DoHyun0226/Line_Tracer/자료/README.md

# 자료

라인트레이서를 만들면서 참고하는 자료를 모아 둔 폴더이다.

## 데이터시트

| 파일 | 내용 |
|---|---|
| [KH42J.pdf](KH42J.pdf) | KH42 스텝모터. KH42JM2-901은 1.8°/스텝, 유니폴라 6선, 1.2A/상 |
| [drv8825.pdf](drv8825.pdf) | DRV8825 스테퍼 드라이버 |
| [tcrt5000.pdf](tcrt5000.pdf) | TCRT5000 적외선 광센서 |

## 구매 자료

| 파일 | 내용 |
|---|---|
| [라인트레이서 추가 구매 체크리스트.pdf](<라인트레이서 추가 구매 체크리스트.pdf>) | 2026-10-13에 작성한 부품 체크리스트 |

## 학습용 HTML

GitHub에서는 소스 코드로만 보이므로, 내려받아 브라우저로 연다.

| 파일 | 내용 |
|---|---|
| [28BYJ-48_Anatomy.html](28BYJ-48_Anatomy.html) | 28BYJ-48 내부 구조와 ULN2003 구동 3D 모델 |
| [Stepper_Wiring.html](Stepper_Wiring.html) | 6선 유니폴라, 5선 유니폴라, 4선 바이폴라 결선과 전류 흐름 비교 |
| [KH42 스테퍼 해부.html](<시뮬레이션/KH42 스테퍼 해부.html>) | KH42JM2-901 구조와 구동 방식 3D 모델 |
| [GPIO_Pull_Guide.html](시뮬레이션/GPIO_Pull_Guide.html) | GPIO 풀업·풀다운 정리와 시뮬레이터 |

## 참고 코드

| 폴더 | 내용 |
|---|---|
| [Arduino_Stepper](Arduino_Stepper) | Arduino Stepper 라이브러리 1.1.3. 스텝모터 구동 방식 참고용이며 라이선스는 폴더 안의 `LICENSE.txt` 참고 |
