DoHyun0226/Line_Tracer/자료/Stepper_Wiring.html

2상 스텝모터 결선 비교

# 핀에서 코일까지 전류 따라가기

6선 유니폴라, 5선 유니폴라, 4선 바이폴라에서 핀이 코일 어디에 연결되고, 스텝마다 전류가 어떻게 흐르는지 비교해 보세요.

6선 유니폴라 5선 유니폴라 4선 바이폴라

2상 여자 1상 여자

◀ 한 스텝 한 스텝 ▶ 자동 진행

## 핀 연결과 현재 상태

## 스텝 순서

## 비교할 점

- 6선과 5선은 스텝마다 켜는 코일이 같아요. 가운데 탭이 코일마다 따로 나오느냐, 모터 안에서 하나로 묶였느냐가 달라요.
- 5선과 4선은 2상 여자에서 자기장 방향이 같아요. 5선은 코일 절반을 골라 켜고, 4선은 코일 전체의 전류 방향을 뒤집어요.
- 5선 모드의 2상 여자 표는 STM32 코드의 step_table 값 0x3, 0x6, 0xC, 0x9와 같은 순서예요.
- 주황·분홍이 한 코일, 노랑·파랑이 한 코일이에요. IN 번호와 선 색의 대응은 보드마다 다를 수 있어요.
- 6선과 4선의 선 이름은 설명용이에요. 실제 선 색은 제품마다 달라서 데이터시트나 멀티미터로 확인해야 해요.
- 그림은 전기적 연결을 보여 주는 회로도예요. 코일의 좌우와 화살표 방향은 실제 극 배치와 일치하지 않아요.
