DoHyun0226/Line_Tracer/실험_사진/28_BYJ_48_Test/2_nucleo_wiring.jpg

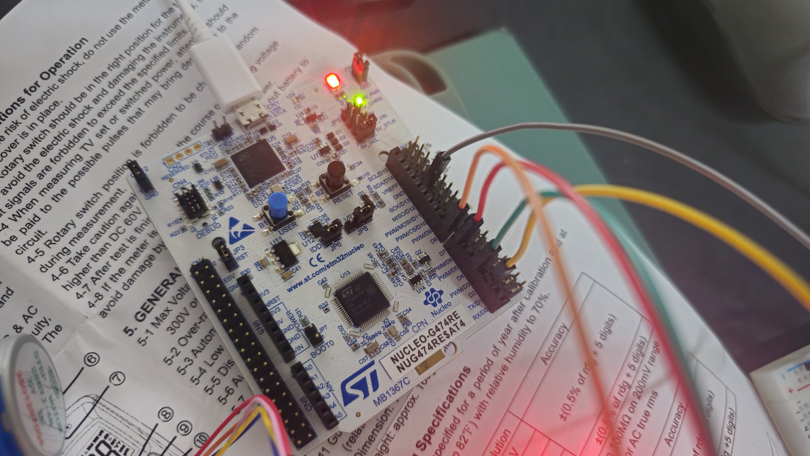
실험_사진/28_BYJ_48_Test/2_nucleo_wiring.jpg
