DoHyun0226/Line_Tracer/실험_사진/TCRT5000_Test/4_nucleo_wiring.jpg

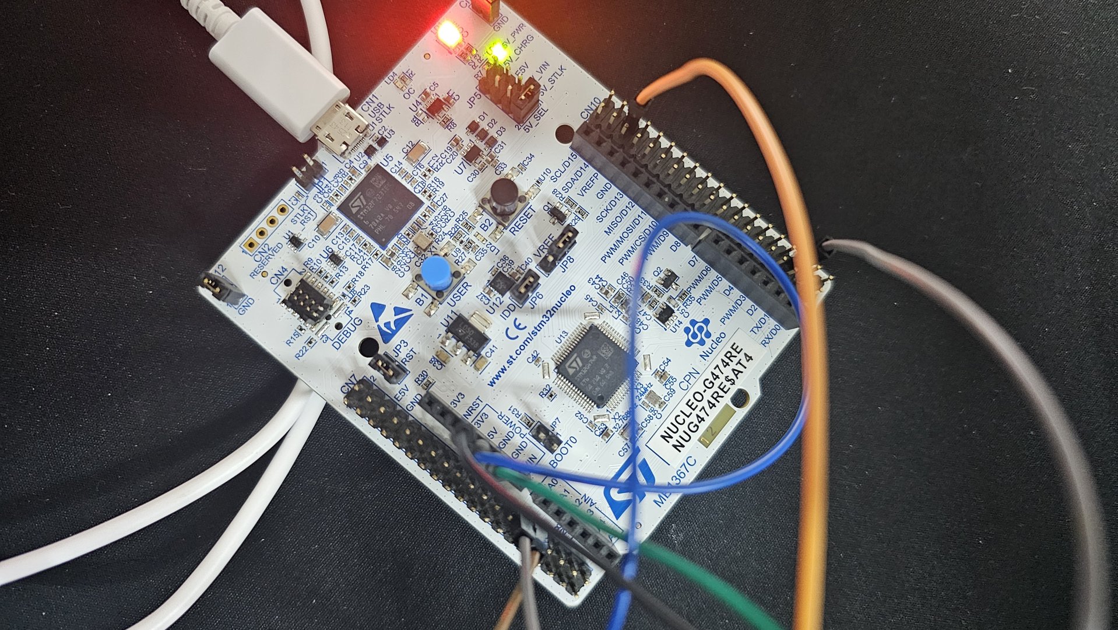
실험_사진/TCRT5000_Test/4_nucleo_wiring.jpg
