DoHyun0226/Line_Tracer/실험_사진/28_BYJ_48_Test/4_uln2003_led_on.jpg

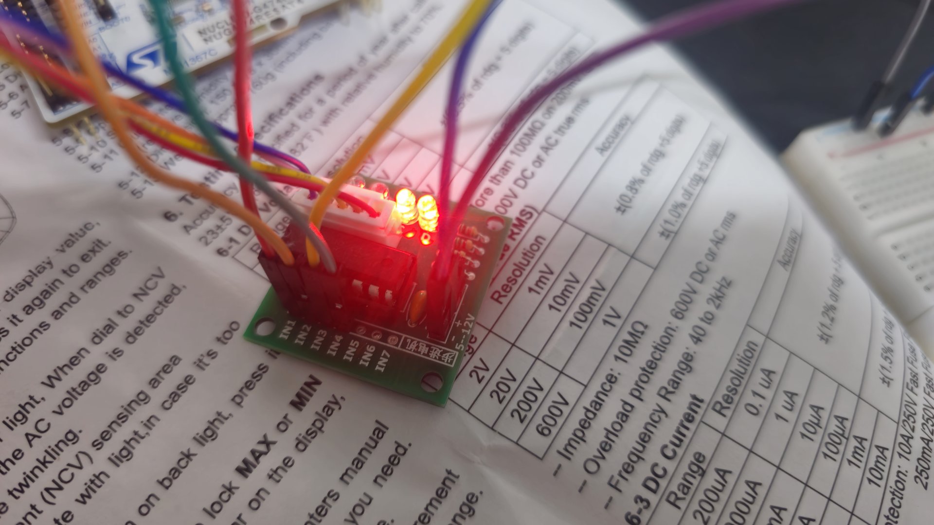
실험_사진/28_BYJ_48_Test/4_uln2003_led_on.jpg
