DoHyun0226/Line_Tracer/실험_사진/TCRT5000_Test/2_tcrt5000_sensors.jpg

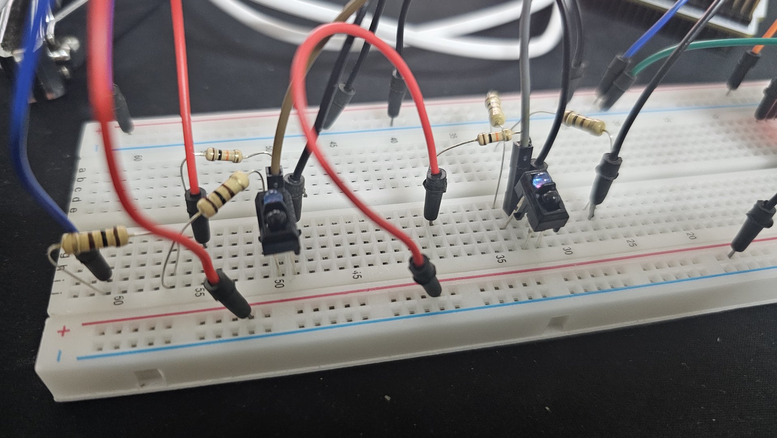
실험_사진/TCRT5000_Test/2_tcrt5000_sensors.jpg
