DoHyun0226/Line_Tracer/실험_사진/TCRT5000_Test/3_bt04a_module.jpg

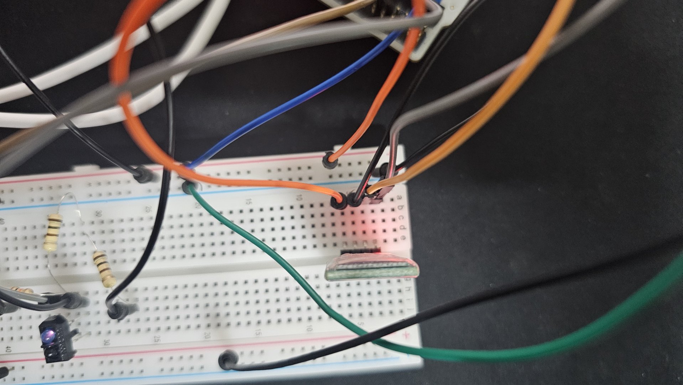
실험_사진/TCRT5000_Test/3_bt04a_module.jpg
