DoHyun0226/Line_Tracer/Project_code/Step_Line_Tracer/Core/Src/main.c

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
/* Includes ------------------------------------------------------------------*/
#include "main.h"
#include "adc.h"
#include "dma.h"
#include "usart.h"
#include "gpio.h"

/* USER CODE BEGIN PD */
#define NUMTCRT_1 6 // number of tcrt 5000 that is connected to the ADC1
#define NUMTCRT_2 6 // number of tcrt 5000 that is connected to the ADC2

//                                     ^ FRONT ^
//
// <-------------- ADC1 --------------->   |   <-------------- ADC2 --------------->
//                                         |
// +-----+-----+-----+-----+-----+-----+   |   +-----+-----+-----+-----+-----+-----+
// | S1  | S2  | S3  | S4  | S5  | S6  |   |   | S7  | S8  | S9  | S10 | S11 | S12 |
// +-----+-----+-----+-----+-----+-----+   |   +-----+-----+-----+-----+-----+-----+
//                                         |
//   PA0   PA1   PB14  PB12  PB1   PB0     |     PA4   PB2   PC5   PC4   PA7   PA6    <- Pin
//   IN1   IN2   IN5   IN11  IN12  IN15    |     IN17  IN12  IN11  IN5   IN4   IN3    <- Channel
//   R1    R2    R3    R4    R5    R6      |     R6    R5    R4    R3    R2    R1     <- Rank
//  b1[0] b1[1] b1[2] b1[3] b1[4] b1[5]    |    b2[5] b2[4] b2[3] b2[2] b2[1] b2[0]   <- DMA buf
//   -11   -9    -7    -5    -3    -1      |     +1    +3    +5    +7    +9    +11    <- Weight
//                                         |
// <<< Rank 1 first                     CENTER                   Rank 1 first >>>
//                                    (error = 0)
/* USER CODE END PD */


void SystemClock_Config(void);
/**
  * @brief  The application entry point.
  * @retval int
  */
int main(void)
{

  /* USER CODE BEGIN 1 */
  /* =====   TCRT5000 (ADC + DMA)   ===== */
  /* DMA keeps overwriting these buffers in the background, so they are
   * volatile: the compiler must re-read them every time instead of caching.
   * Index order follows the sensor diagram above (b1[k] and b2[k] are a
   * left/right mirror pair around the center). */
  volatile uint16_t buf_tcrt_1[NUMTCRT_1] = {0,}; // adc1 data (S1~S6), updated by DMA
  volatile uint16_t buf_tcrt_2[NUMTCRT_2] = {0,}; // adc2 data (S7~S12), updated by DMA

  /* =====   PID   ===== */
  /* Use float, not double:
   * The STM32G4 (Cortex-M4F) FPU supports single precision (float) only.
   * double operations are not handled by the hardware FPU and are emulated
   * in software, which is much slower. Use float literals too (e.g. 1.0f). */
  float k_p, k_i, k_d; 					// PID coefficients (Kp, Ki, Kd), tuning constants
  float gain_p, gain_i, gain_d; 		// P, I, D term outputs, recalculated every tick (e.g. gain_p = k_p * err_curr)
  float err_curr; 						// current error (line position, -11 ~ +11, 0 = center)
  float	err_prev;						// previous error (last tick, used for D term)
  /* USER CODE END 1 */

  /* MCU Configuration--------------------------------------------------------*/

  /* Reset of all peripherals, Initializes the Flash interface and the Systick. */
  HAL_Init();

  /* Configure the system clock */
  SystemClock_Config();

  /* Initialize all configured peripherals */
  MX_GPIO_Init();
  MX_DMA_Init();
  MX_ADC1_Init();
  MX_ADC2_Init();
  MX_USART1_UART_Init();
  /* USER CODE BEGIN 2 */
  HAL_ADCEx_Calibration_Start(&hadc1, ADC_SINGLE_ENDED); 				// ADC1 Calibration
  HAL_ADCEx_Calibration_Start(&hadc2, ADC_SINGLE_ENDED);       			// ADC2 Calibration
  HAL_ADC_Start_DMA(&hadc1, (uint32_t *)buf_tcrt_1, NUMTCRT_1);		// ADC1 and ADC1_dma start
  HAL_ADC_Start_DMA(&hadc2, (uint32_t *)buf_tcrt_2, NUMTCRT_2);		// ADC2 and ADC2_dma start
  /* USER CODE END 2 */

  /* Infinite loop */
  /* USER CODE BEGIN WHILE */
  while (1)
  {
    /* USER CODE END WHILE */

    /* USER CODE BEGIN 3 */
  }
  /* USER CODE END 3 */
}

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
