DoHyun0226/Line_Tracer/Project_code/Step_Line_Tracer/Step_Line_Tracer.ioc

Mcu.UserName=STM32G474RETx
PA0.Signal=ADC1_IN1
PA1.Signal=ADC1_IN2
PA10.Signal=USART1_RX
PA13.Signal=SYS_JTMS-SWDIO
PA14.Signal=SYS_JTCK-SWCLK
PA4.Signal=ADC2_IN17
PA6.Signal=ADC2_IN3
PA7.Signal=ADC2_IN4
PA9.Signal=USART1_TX
PB0.Signal=ADC1_IN15
PB1.Signal=ADC1_IN12
PB12.Signal=ADC1_IN11
PB14.Signal=ADC1_IN5
PB2.Signal=ADC2_IN12
PC4.Signal=ADC2_IN5
PC5.Signal=ADC2_IN11
PF0-OSC_IN.Signal=RCC_OSC_IN
PF1-OSC_OUT.Signal=RCC_OSC_OUT
