DoHyun0226/Line_Tracer/(commit log)

2026-11-02 프로젝트 초기 구성: 28BYJ-48 구동 실험과 자료 추가
    - step_motor: 버튼으로 28BYJ-48 스텝모터를 돌리는 테스트 프로젝트
    - 실험_사진: 28BYJ-48 실험 사진 축소본
    - 자료: 데이터시트, 구매 체크리스트, 학습용 HTML, Arduino Stepper 라이브러리
    - README와 .gitignore 작성
2026-11-09 자료: tcrt5000 데이터시트에 공부 메모 추가
2026-11-09 ADC_TCRT5000: TCRT5000 2채널을 ADC1 + DMA로 읽어 블루투스로 출력
    PA0/PA1(ADC1_IN1/IN2)을 Continuous + DMA Circular로 계속 읽고,
    0.1초마다 snprintf로 만든 문자열을 USART1(BT04-A, 9600bps)로 보낸다.
    main.c 주석에 회로, CubeMX 설정, 헷갈렸던 개념을 정리했다.
2026-11-09 TCRT5000_Test: 실험 사진, 회로도, 측정 기록 추가
    - 사진 4장을 1920x1080으로 줄이고 내용에 맞게 이름을 붙임
    - 전체 회로도(circuit_schematic.svg)와 흰색/검은색 측정값 정리
    - 원본/, 영상/ 폴더 무시 규칙을 모든 실험 폴더에 적용
    - README에 ADC_TCRT5000 프로젝트와 진행 상황 추가
2026-11-09 TCRT5000_Test, ADC_TCRT5000: README에 실험 영상(YouTube) 링크 추가
2026-11-12 Step_Line_Tracer: TCRT5000 12채널 ADC1/ADC2 + DMA 구성 시작
    STM32G474에서 TCRT5000 12개를 ADC1(S1~S6), ADC2(S7~S12) 각 6채널로 읽도록
    CubeMX 프로젝트를 만들었다. 좌우 바깥쪽 센서가 Rank 1이 되도록 채널을 배치해
    buf_tcrt_1[k]와 buf_tcrt_2[k]가 중앙 기준 대칭 쌍이 되게 했다.
    - main.c에 센서 배열, 핀, 채널, Rank, DMA 버퍼, PID 가중치 그림 주석 추가
    - PID 파라미터를 double 대신 float으로 쓰는 이유(M4F FPU는 단정밀도만 지원) 주석
    - 자료: 핀 배치표(pin_배치.xlsx) 추가
    아직 작성 중이라 빌드되지 않는다 (HAL_ADC_Start_DMA 인자, 세미콜론 등 미완성).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
    [pin_배치.xlsx]
2026-11-12 Step_Line_Tracer: main.c 빌드 오류 수정
    - 센서 배열 그림 주석 위에 // 없이 남아 있던 줄 삭제
    - 그림 마지막 줄의 중복된 (error = 0) 제거
    - HAL_ADC_Start_DMA 첫 인자를 DMA 핸들(&hdma_adcX)에서 ADC 핸들(&hadcX)로
    바꾸고 빠진 세미콜론 추가
    이제 컴파일 오류 없이 빌드된다 (PID 변수 미사용 경고만 남음).
    [main.c]
2026-11-12 Step_Line_Tracer: ADC 버퍼 volatile, PID 변수 선언과 주석 추가
    - DMA가 계속 덮어쓰는 buf_tcrt_1/2를 volatile로 바꾸고 이유를 주석으로 정리
    - 버퍼 인덱스가 센서 그림의 좌우 대칭 쌍(b1[k] <-> b2[k])을 따른다는 설명 추가
    - PID 변수(k_p/k_i/k_d, gain_p/gain_i/gain_d, err_curr, err_prev) 선언과 주석
    err_curr는 가중평균 라인 위치(-11 ~ +11, 0 = 중앙), err_prev는 D항용 이전 오차
2026-11-12 Step_Line_Tracer: PID 계수와 항 결과 변수 주석 구분
    k_p/k_i/k_d는 튜닝하는 PID 계수(coefficient), gain_p/gain_i/gain_d는
    매 tick 계산되는 P, I, D 항 결과값(예: gain_p = k_p * err_curr)이라고 주석에 명시.
