DoHyun0226/Line_Tracer/(notices)

Notices in the files:
Project_code/Step_Line_Tracer/Core/Src/main.c:
Copyright (c) 2026 STMicroelectronics.
All rights reserved.
This software is licensed under terms that can be found in the LICENSE file
